wbyne/dl_2_eagle/afb_r005_BOM_7May21_2250.ods

Component | Supplier | Part_No | Value | Type | Size | Item | Part | Part_Source | Schematic_Part | Value | Device | Package | Description | AVAILABILITY | BOM | BUILT_BY | COPYRIGHT | DATASHEET | DESCRIPTION | DIGI-KEY_PART_NUMBER | MANUFACTURER_PART_NUMBER | MF | MP | MPN | OC_FARNELL | OC_NEWARK | PACKAGE | PRICE | PURCHASE-URL | SOURCELIBRARY | SUPPLIER | VENDOR
RTC | Digikey | 36-1070CT-ND - Cut Tape (CT) |  | SMD |  | CR1120 SMD Coin Cell holder | B1 | Schematic | B1 | cr1220 | BATTERYCR1220_2 | CR1220-2 | CR1220 SMT - Digikey: 3001K-ND
Power_Supply | Mouser | 81-GRM21R60J226ME39L | 22uF/6.3V | SMD |  |  | C2 | Datasheet | C4 | 22uF | C-USC0805 | C0805 | CAPACITOR, American symbol
Power_Supply | Mouser | 81-GRM21A5C2E201JW1D | 200pF | SMD |  |  | C3 | Datasheet | C5 | 200pF | C-USC0805 | C0805 | CAPACITOR, American symbol
Power_Supply | Mouser | 81-GRT21BC71E106KE13 | 10uF/24V | SMD |  |  | C1 | Datasheet | C6 | 10uF | C-USC0805 | C0805 | CAPACITOR, American symbol
Power_Supply | Mouser | 80-C0805X104M5RACTU | 100nF | SMD |  |  | C4 | Datasheet | C7 | 100nF | C-USC0805 | C0805 | CAPACITOR, American symbol
Power_Supply | Mouser | 81-GRM21R60J226ME39L | 22uF/6.3V | SMD |  |  | C2 | Datasheet | C8 |  | C-USC0805 | C0805 | CAPACITOR, American symbol
Relay | Mouser | 512-1N4148 | 1N4148 |  |  |  |  | Schematic | D1 | 1N4148 | DIODESOD-323 | SOD-323 | Diode
 | Mouser | SML-H12U8TT86C |  |  |  |  |  |  | D2 | RED | LED0805_NOOUTLINE | CHIPLED_0805_NOOUTLINE | LED
Power_Supply | Mouser | 621-B340A-F | B340A-13-F | SMD |  | DIODES INC. - B340A-13-F - Schottky Rectifier, 40 V, 3 A, Single, DO-214AC (SMA), 2 Pins, 500 mV | D1 | Datasheet | D4 | B340A-13-F | B340A-13-F | DIOM5226X240N | Diode, Rectifier, 3a, 40v, Do-214ac, Full Reel |  |  |  |  |  | Diode Schottky 40V 3A Surface Mount SMA | B340A-FDICT-ND |  | Diodes Inc. | B340A-13-F |  |  |  | DO-214 Diodes Inc. |  | https://pricing.snapeda.com/search/part/B340A-13-F/?ref=eda
 |  |  |  |  |  |  |  |  | FID1 | FIDUCIAL_1MM | FIDUCIAL_1MM | FIDUCIAL_1MM | Fiducial Alignment Points |  | EXCLUDE
RTC | Digikey | 700-DS3231SN# | DS3231 | SMD |  |  | DS3231 | Schematic | IC2 | DS3231/SO | DS3231/SO | SO16W |  | Unavailable |  |  |  |  | Real Time Clock (RTC) IC Clock/Calendar I²C, 2-Wire Serial 16-SOIC (0.295, 7.50mm Width) |  |  | Maxim Integrated | DS3231 |  |  |  | SOIC-16 Maxim Integrated | None
Feather_Mount | Mouser/Adafruit | 485-2830 |  |  |  | 12pin/16pin Stacking Headers for Feather | JP2/JP8 | Schematic | JP2 |  | HEADER-1X16ROUND | 1X16_ROUND | PIN HEADER
 | Mouser/Adafruit | 485-392 |  |  |  | 10 Pack of Male Headers |  |  | JP3 |  | PINHD-1X12-CB | 1X12-CB | PIN HEADER
 |  |  |  |  |  | 10 Pack of Male Headers |  |  | JP4 |  | HEADER-1X1ROUND | 1X01_ROUND | PIN HEADER
 |  |  |  |  |  | 10 Pack of Male Headers |  |  | JP5 |  | PINHD-1X12-CB | 1X12-CB | PIN HEADER
 |  |  |  |  |  | 10 Pack of Male Headers |  |  | JP6 |  | HEADER-1X1ROUND | 1X01_ROUND | PIN HEADER
 |  |  |  |  |  | 10 Pack of Male Headers |  |  | JP7 |  | PINHD-1X18 | 1X18 | PIN HEADER
Feather_Mount | Mouser/Adafruit | 485-2830 |  |  |  | 12pin/16pin Stacking Headers for Feather | JP2/JP8 | Schematic | JP8 |  | PINHD-1X12-CB | 1X12-CB | PIN HEADER
Power_Supply | Digikey | 732-4115-1-ND - Cut Tape (CT) | 15uH | SMD |  |  | L1 | Datasheet | L1 | 15uH | WE-PD-744771115_1260/1245/1280/1210 | WE-PD_1260/1245/1280/1210 | SMD-Shielded Power Inductors WE-PD |  |  |  |  |  |  |  |  |  |  | 744771115 | 1635908 | 08P2786 | 1260 |  |  |  | Wuerth Elektronik
 | Mouser | 863-NSVMMBT2222AM3T5 |  |  |  |  |  |  | Q1 | MMBT2222 | TRANSISTOR_NPN | SOT23-R | NPN Transistor
SCL_Pullup |  |  | 10k |  |  |  | R1 | Schematic | R1 | 10K | RESISTOR_0603_NOOUT | 0603-NO | Resistors
SDA_Pullup |  |  | 10k |  |  |  | R2 | Schematic | R2 | 10K | RESISTOR_0603_NOOUT | 0603-NO | Resistors
SD_CS_Pullup |  |  | 100k |  |  |  | R3 | Schematic | R3 | 100K | RESISTOR_0603_NOOUT | 0603-NO | Resistors
RTC | Mouser | 71-CRCW080510K0JNEAC | 10k | SMD |  |  | R4 | Schematic | R4 | 10k | R-US_R0805 | R0805 | RESISTOR, American symbol
 | Mouser | 71-CRCW08051K00JNEAC |  |  |  |  |  |  | R5 | 1K | RESISTOR0805_NOOUTLINE | 0805-NO | Resistors
 | Mouser | 71-CRCW080510K0JNEAC |  |  |  |  |  |  | R6 | 10K | RESISTOR0805_NOOUTLINE | 0805-NO | Resistors
 | Mouser | 71-CRCW080510K0JNEAC |  |  |  |  |  |  | R7 | 10K | RESISTOR0805_NOOUTLINE | 0805-NO | Resistors
Power_Supply | Mouser | 71-TNPW080540K2BEEA | 40.2k | SMD | 805 | resistor | R2 | Datasheet | R8 | 40.2k | R-US_R0805 | R0805 | RESISTOR, American symbol
Power_Supply | Mouser | 71-CRCW0805-365K-E3 | 365k | SMD |  |  | R4 | Datasheet | R9 | 365k | R-US_R0805 | R0805 | RESISTOR, American symbol
Power_Supply | Mouser | 71-CRCW0805-63.4K | 63.4k | SMD |  |  | R3 | Datasheet | R10 | 63.4k | R-US_R0805 | R0805 | RESISTOR, American symbol
Power_Supply | Mouser | 71-CRCW0805-162K | 162k | SMD | 805 | resistor | R1 | Datasheet | R15 | 162k | R-US_R0805 | R0805 | RESISTOR, American symbol
Feather_Mount | Mouser | 612-TL6330AF200Q |  |  |  | SWITCH_TACT_SMT4.6X2.8 (SWITCH_TACT_SMT) |  |  | SW1 | KMR2 | SWITCH_TACT_SMT4.6X2.8 | BTN_KMR2_4.6X2.8 | SMT Tact Switches
 |  |  |  |  |  |  |  |  | U1 | MP1584 | MP1584 | SOIC8E_MPS |  |  |  | EMA_Cory | Copyright (C) 2018 Accelerated Designs. All rights reserved | https://www.monolithicpower.com/en/documentview/productdocument/index/version/2/document_type/Datasheet/lang/en/sku/MP1584/document_id/204 |  |  | MP1584 |  |  |  |  |  |  |  |  | MPS_2020-01-27 |  | Monolithic Power Systems Inc
 | Digikey | 399-11000-1-ND - Cut Tape (CT) |  |  |  |  |  |  | X1 | RELAY_NONLATCHING-EE2NUH | RELAY_NONLATCHING-EE2NUH | RELAY_EE2_NOLATCH
 | Mouser | 651-1071011 |  |  |  |  |  |  | X3 |  | TERMBLOCK_1X3 | TERMBLOCK_1X3-3.5MM | 3.5mm Terminal block
 | Mouser | 538-47352-1001 |  |  |  |  |  |  | X4 | microsd | MICROSD | MICROSD | MicroSD/Transflash Card Holder with SPI pinout
Power_Supply |  |  | N/A | SMD |  |  | R5 | Datasheet
Power_Supply |  |  | N/A | SMD |  |  | R6 | Datasheet
