wbyne/dl_2_eagle/DL3R1005C_export_from_mouser_13may21_0915.xls

DL3R1005C_LMR23610
Mouser # | Mfr. # | Manufacturer | Customer # | Description | RoHS | Lifecycle | Order Qty. | Price (USD) | Ext.: (USD)
603-RT0805FRE0766K5L | RT0805FRE0766K5L | Yageo |  | Thin Film Resistors - SMD 1/8W 66.5K ohm 1% 50ppm | RoHS Compliant By Exemption |  | 10 | $0.055 | $0.55
71-TNPW080522K1FEEA | TNPW080522K1FEEA | Vishay |  | Thin Film Resistors - SMD 22.1Kohms 1% 25ppm | RoHS Compliant |  | 10 | $0.318 | $3.18
595-LMR23610ADDA | LMR23610ADDA | Texas Instruments |  | Switching Voltage Regulators 36V, 1A, Sync Step-Down | RoHS Compliant |  | 10 | $3.47 | $34.70
810-C3225X7R1H106MAC | C3225X7R1H106M250AC | TDK |  | Multilayer Ceramic Capacitors MLCC - SMD/SMT RECOMMENDED ALT 810-C3225X7R1H106250 | RoHS Compliant |  | 10 | $0.612 | $6.12
994-MSS6132T-223MLC | MSS6132T-223MLC | Coilcraft |  | Fixed Inductors 22uH Shld 20% 1.9A 158mOhms | RoHS Compliant |  | 10 | $1.26 | $12.60
963-UMF212B7104KGHT | UMF212B7104KGHT | Taiyo Yuden |  | Multilayer Ceramic Capacitors MLCC - SMD/SMT 0805 50VDC 0.1uF 10% X7R AEC-Q200 | RoHS Compliant | New Product | 10 | $0.101 | $1.01
74-T55A107M6R3C0100 | T55A107M6R3C0100 | Vishay |  | Tantalum Capacitors - Polymer 100uF 6.3volts 20% A Case 100 Max. ESR | RoHS Compliant |  | 10 | $0.55 | $5.50
187-CL21B225KPFNNNG | CL21B225KPFNNNG | Samsung Electro-Mechanics |  | Multilayer Ceramic Capacitors MLCC - SMD/SMT 2.2uF+/-10% 10V X7R 2012 | RoHS Compliant | New At Mouser | 10 | $0.086 | $0.86
652-CMP0805AFX-1003L | CMP0805AFX-1003ELF | Bourns |  | Thick Film Resistors - SMD 100K OHM 1% 1/2W TC100 | RoHS Compliant | New Product | 10 | $0.115 | $1.15
78-1N4148WS-E3-08 | 1N4148WS-E3-08 | Vishay |  | Diodes - General Purpose, Power, Switching 100 Volt 350mA | RoHS Compliant |  | 10 | $0.201 | $2.01
80-EE2-12NUX-L | EE2-12NUX-L | KEMET |  | Low Signal Relays - PCB KEMET, EE2, Relays, Signal | RoHS Compliant |  | 10 | $1.83 | $18.30
71-CRCW080510K0JNEAC | CRCW080510K0JNEAC | Vishay | R4 | Thick Film Resistors - SMD 1/8Watt 10Kohms 5% Commercial Use | RoHS Compliant By Exemption |  | 10 | $0.039 | $0.39
538-47352-1001 | 47352-1001 | Molex | X4 | Memory Card Connectors TFR PUSH PUSH TYPE V YPE VSS DEECT SWITCH | RoHS Compliant |  | 10 | $3.32 | $33.20
651-1071011 | 1071011 | Phoenix Contact | X3 | Fixed Terminal Blocks SPTAF 1/ 3-3 5-IL-EX |  | New Product | 10 | $1.87 | $18.70
612-TL6330AF200Q | TL6330AF200Q | E-Switch | SW1 | Tactile Switches SMT, miniature, IP67, 2.80mm x 4.60mm x 1.90mm tact switch, 1VA @ 32VDC, SPST, 200gf | RoHS Compliant |  | 10 | $0.68 | $6.80
71-CRCW08051K00JNEAC | CRCW08051K00JNEAC | Vishay | R5 | Thick Film Resistors - SMD 1/8Watt 1Kohms 5% Commercial Use | RoHS Compliant By Exemption |  | 10 | $0.039 | $0.39
863-NSVMMBT2222AM3T5 | NSVMMBT2222AM3T5G | ON Semiconductor | Q1 | Bipolar Transistors - BJT SS SOT-723 GP TRANSISTOR | RoHS Compliant |  | 10 | $0.314 | $3.14
485-2830 | 2830 | Adafruit | JP2 | Adafruit Accessories Stacking Headers for Feather - 12-pin and 16-pin female headers | RoHS Compliant |  | 10 | $1.25 | $12.50
485-392 | 392 | Adafruit | JP3-7 | Adafruit Accessories 36-pin Male Header Breakaway 10 pieces | RoHS Compliant |  | 4 | $4.95 | $19.80
700-DS3231S# | DS3231S# | Maxim Integrated | IC2 | Real Time Clock Extremely Accurate I C-Integrated RTC/TCXO/Crystal | RoHS Compliant By Exemption |  | 10 | $8.07 | $80.70
755-SML-H12U8TT86C | SML-H12U8TT86C | ROHM Semiconductor | D2 | Standard LEDs - SMD Red 620nm 40mcd 2.2V; 20mA 0805 | RoHS Compliant |  | 10 | $0.283 | $2.83
855-S8411-45R | S8411-45R | Harwin | B1 | Coin Cell Battery Holders EZ BDWR, SMT COIN CELL HOLDER CR1220 | RoHS Compliant |  | 10 | $1.02 | $10.20
