wbyne/dl_2_eagle/afb_r003_sch.pdf

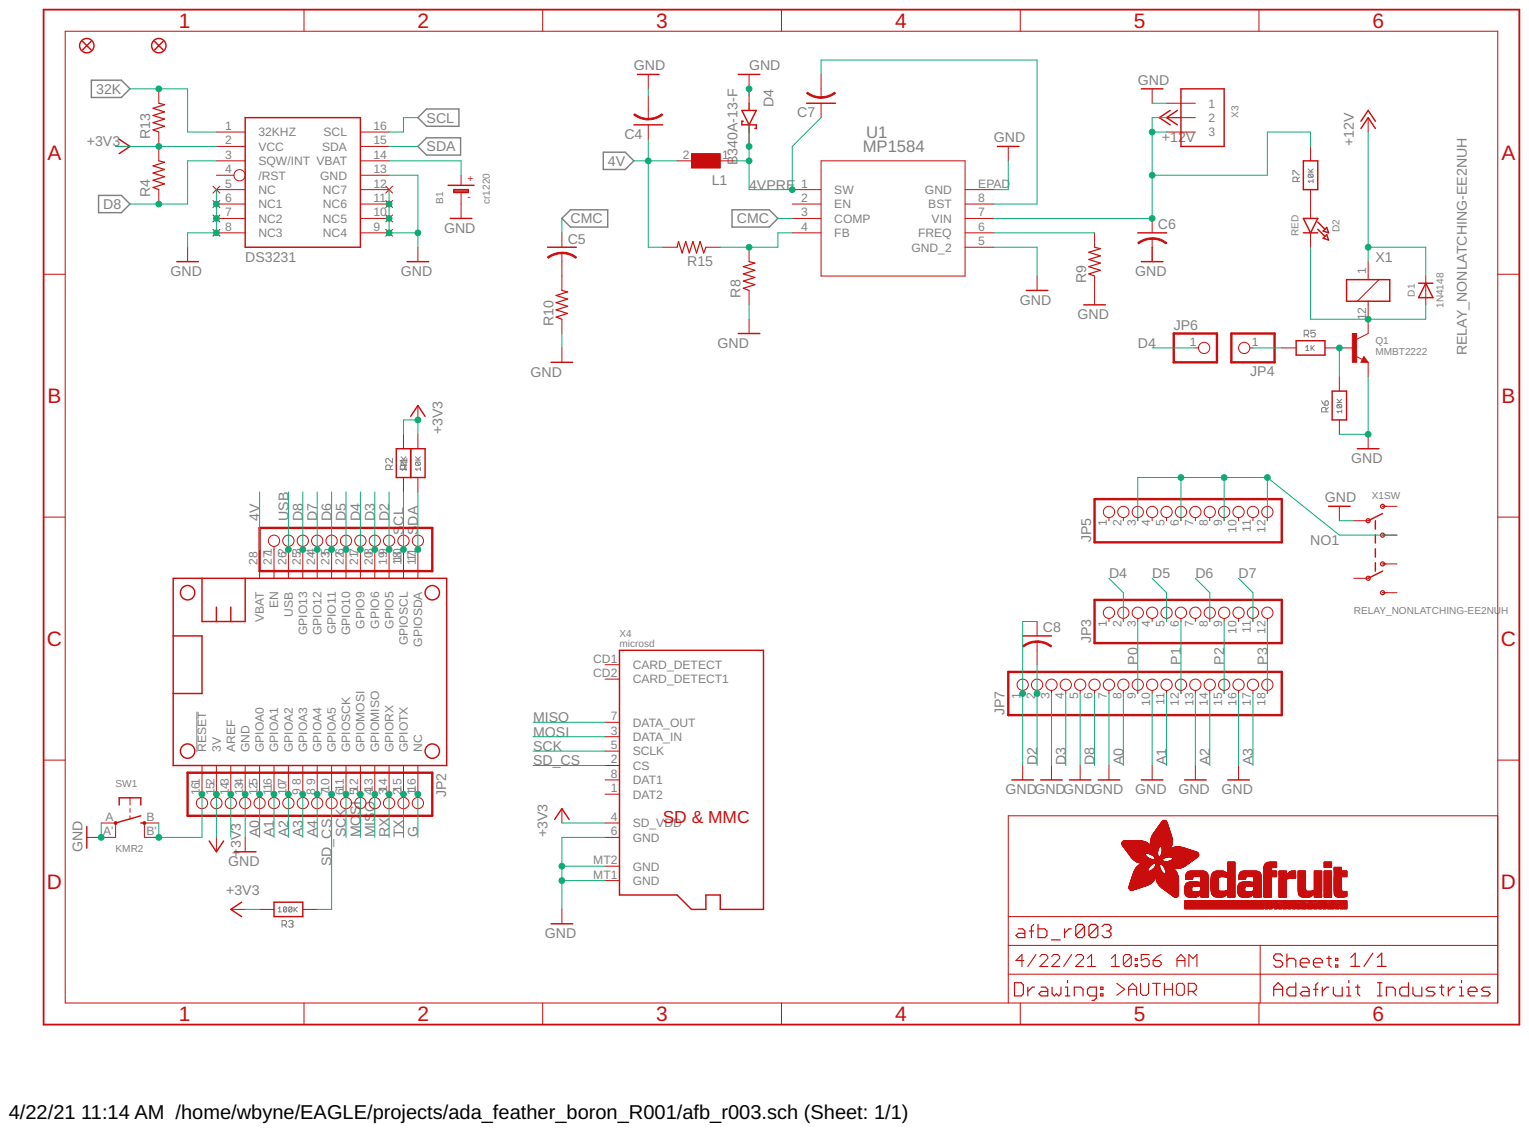
[picture p1: page 1]

GNDGNDGNDGND GND GND GND

4/22/21 11:14 AM /home/wbyne/EAGLE/projects/ada_feather_boron_R001/afb_r003.sch (Sheet: 1/1)
