wbyne/dl_2_eagle/afb_r003.pdf

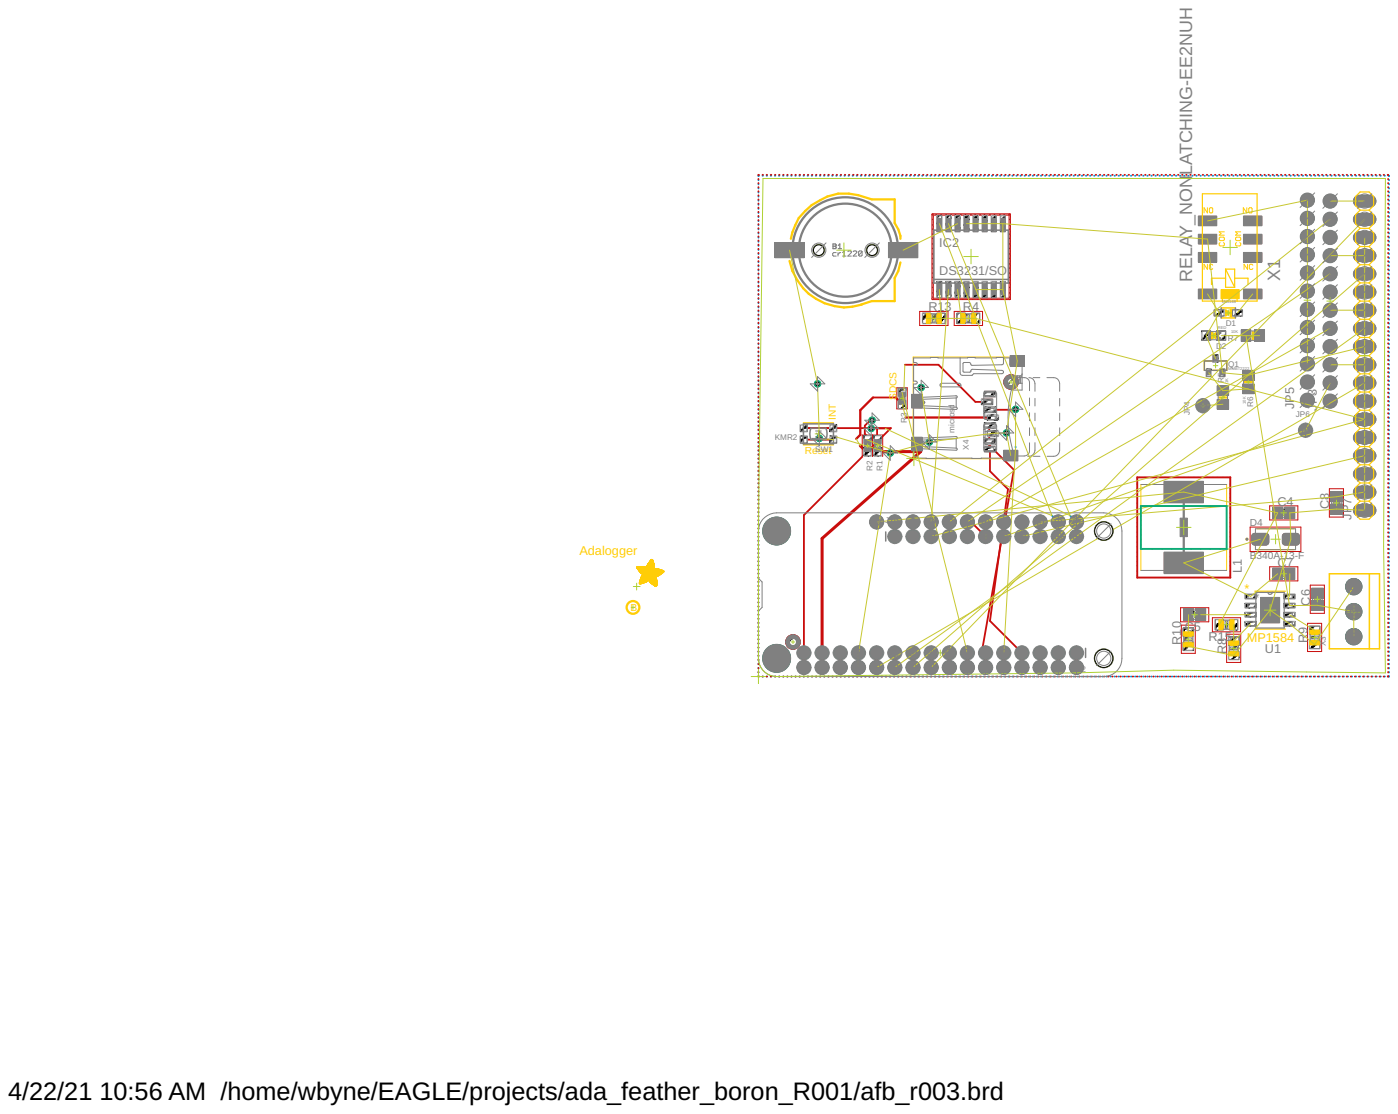
[picture p2: page 1]

4/22/21 10:56 AM /home/wbyne/EAGLE/projects/ada_feather_boron_R001/afb_r003.brd
