wbyne/dl_2_eagle/afb_r005_revc.brd

## EAGLE design afb_r005_revc.brd (2021-05-13)

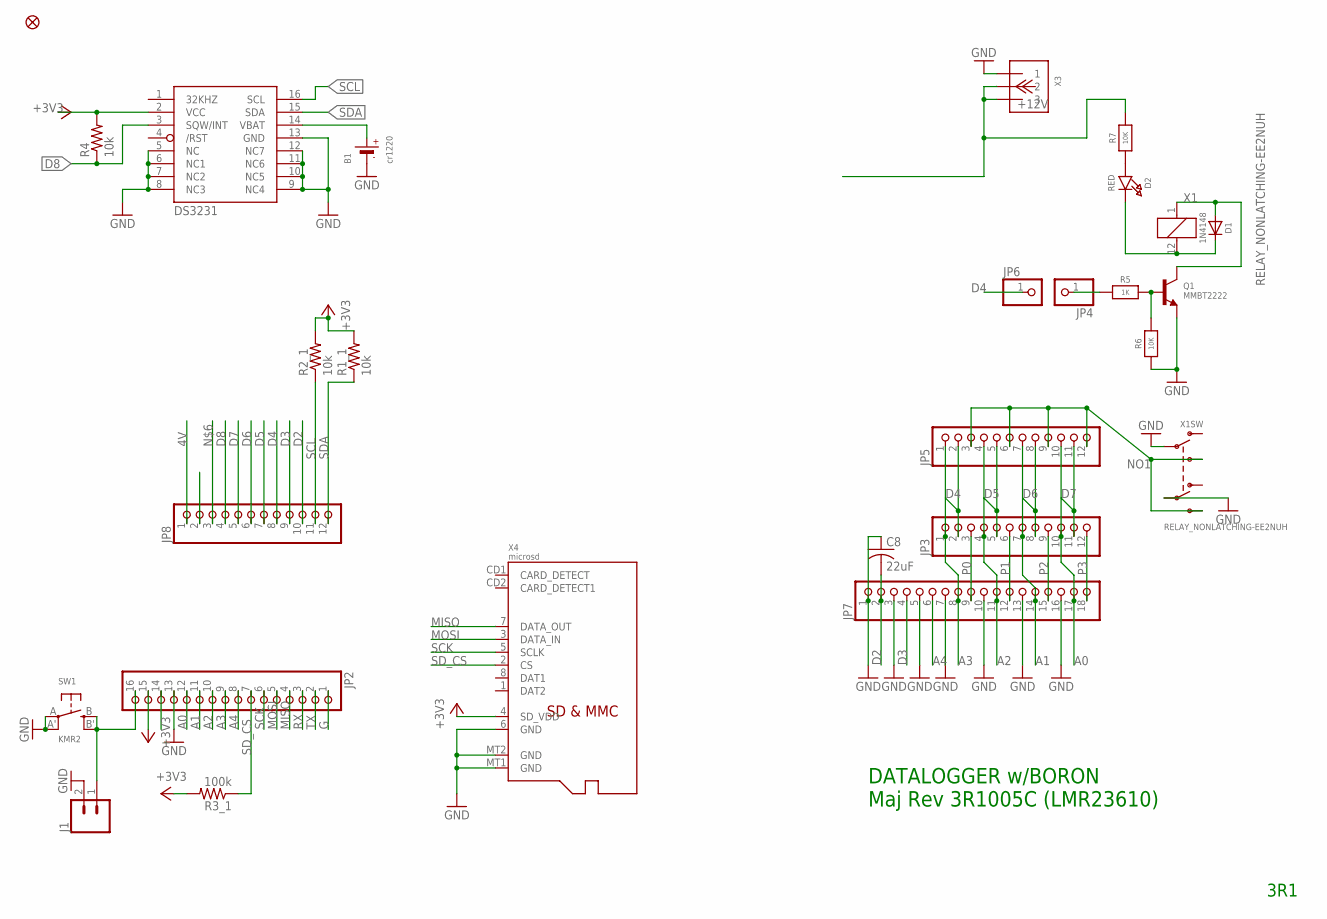
[picture p3: schematic afb_r005_revc.sch, sheet 1]

Parts:
B1: cr1220; CR1220-2
C8: 22uF; C0805
D1: 1N4148; SOD-323
D2: RED; CHIPLED_0805_NOOUTLINE
FID1: FIDUCIAL_1MM
IC2: DS3231/SO; SO16W
J1: CONN_02; 1X02
JP2: HEADER-1X16ROUND; 1X16_ROUND
JP3, JP5, JP8: PINHD-1X12-CB; 1X12-CB
JP4, JP6: HEADER-1X1ROUND; 1X01_ROUND
JP7: PINHD-1X18; 1X18
Q1: MMBT2222; SOT23-R
R1_1, R2_1, R4: 10k; R0805
R3_1: 100k; R0805
R5: 1K; 0805-NO
R6, R7: 10K; 0805-NO
SW1: KMR2; BTN_KMR2_4.6X2.8
X1: RELAY_NONLATCHING-EE2NUH; RELAY_EE2_NOLATCH
X3: TERMBLOCK_1X3; TERMBLOCK_1X3-3.5MM
X4: microsd; MICROSD

Connections:
4V: JP8.1; also elsewhere on the board
+3V3: IC2.2 (VCC), JP2.15, R1_1.2, R2_1.2, R3_1.2, R4.2, X4.4 (SD_VDD)
A0: JP2.12, JP3.10, JP5.10, JP7.17
A1: JP2.11, JP3.7, JP5.7, JP7.14
A2: JP2.10, JP3.4, JP5.4, JP7.11
A3: JP2.9, JP3.1, JP5.1, JP7.8
A4: JP2.8, JP7.6
AREF: JP2.14
D2: C8.2, JP7.2, JP8.10
D3: JP7.4, JP8.9
D4: JP3.2, JP5.2, JP6.1, JP8.8
D5: JP3.5, JP5.5, JP8.7
D6: JP3.8, JP5.8, JP8.6
D7: JP3.11, JP5.11, JP8.5
D8: IC2.3 (SQW/INT), JP8.4, R4.1
G: JP2.1
GND: B1.-, C8.1, IC2.5 (NC), IC2.6 (NC1), IC2.7 (NC2), IC2.8 (NC3), IC2.9 (NC4), IC2.10 (NC5), IC2.11 (NC6), IC2.12 (NC7), IC2.13 (GND), J1.2, JP2.13, JP7.1, JP7.3, JP7.5, JP7.7, JP7.10, JP7.13, JP7.16, Q1.2 (E), R6.1, SW1.A, SW1.A' (P1), X1.4 (P2), X1.9 (P1), X3.1, X4.6 (GND), X4.MT1 (GND), X4.MT2 (GND); also elsewhere on the board
MISO: JP2.4, X4.7 (DATA_OUT)
MOSI: JP2.5, X4.3 (DATA_IN)
unnamed: B1.+, IC2.14 (VBAT)
unnamed: D1.A, Q1.3 (C), X1.1
unnamed: D1.C, D2.C, X1.12 (2)
unnamed: Q1.1 (B), R5.2, R6.2
unnamed: JP4.1, R5.1
unnamed: D2.A, R7.1
NO1: JP5.3, JP5.6, JP5.9, JP5.12, X1.5 (S2), X1.8 (S1)
P0: JP3.3, JP7.9
P1: JP3.6, JP7.12
P2: JP3.9, JP7.15
P3: JP3.12, JP7.18
RESET: J1.1, JP2.16, SW1.B (S), SW1.B' (S1)
RX: JP2.3
SCK: JP2.6, X4.5 (SCLK)
SCL: IC2.16 (SCL), JP8.11, R2_1.1
SDA: IC2.15 (SDA), JP8.12, R1_1.1
SD_CS: JP2.7, R3_1.1, X4.2 (CS)
TX: JP2.2
VIN: R7.2, X3.2, X3.3; also elsewhere on the board

Notes on the sheet:
DATALOGGER w/BORON Maj Rev 3R1005C (LMR23610)
3R1

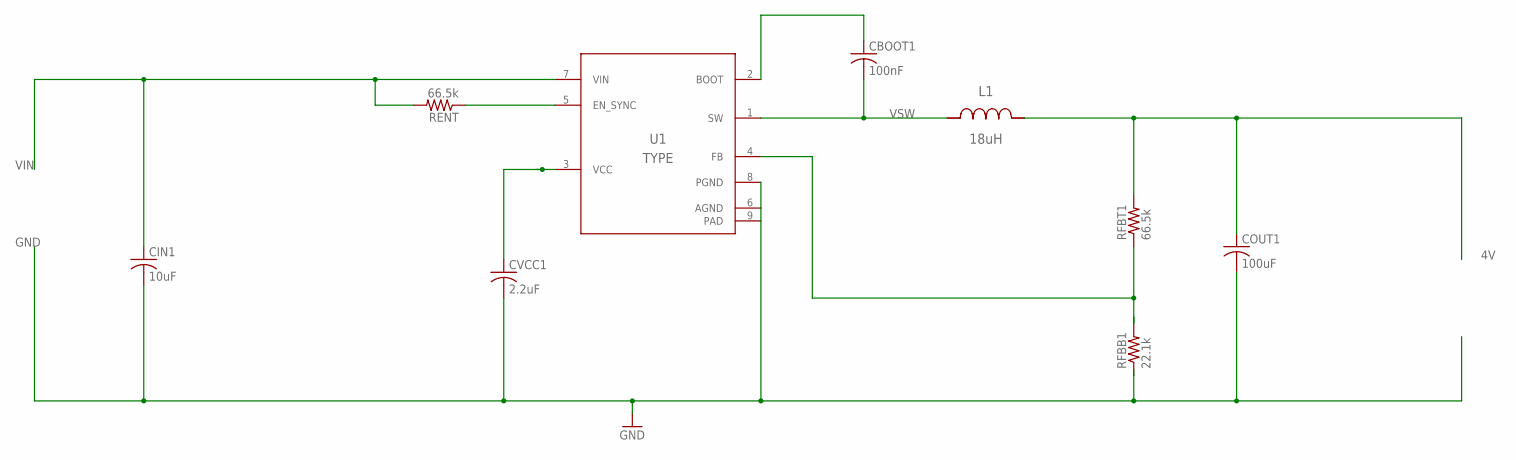
[picture p4: schematic afb_r005_revc.sch, sheet 2]

Parts:
CBOOT1: 100nF; C0805
CIN1: 10uF; C0805
COUT1: 100uF; C3216
CVCC1: 2.2uF; C0805
L1: 18uH; IND_NPI54C
RENT: 66.5k; R0805
RFBB1: 22.1k; R0805
RFBT1: 66.5k; R0805
U1: Value; DDA0008E_N

Connections:
3: CVCC1.1, U1.3 (VCC)
4: CBOOT1.1, U1.2 (BOOT)
4V: COUT1.1, L1.2, RFBT1.2; also elsewhere on the board
FB: RFBB1.2, RFBT1.1, U1.4 (FB)
GND: CIN1.2, COUT1.2, CVCC1.2, RFBB1.1, U1.6 (AGND), U1.8 (PGND), U1.9 (PAD); also elsewhere on the board
unnamed: RENT.1, U1.5 (EN_SYNC)
VIN: CIN1.1, RENT.2, U1.7 (VIN); also elsewhere on the board
VSW: CBOOT1.2, L1.1, U1.1 (SW)

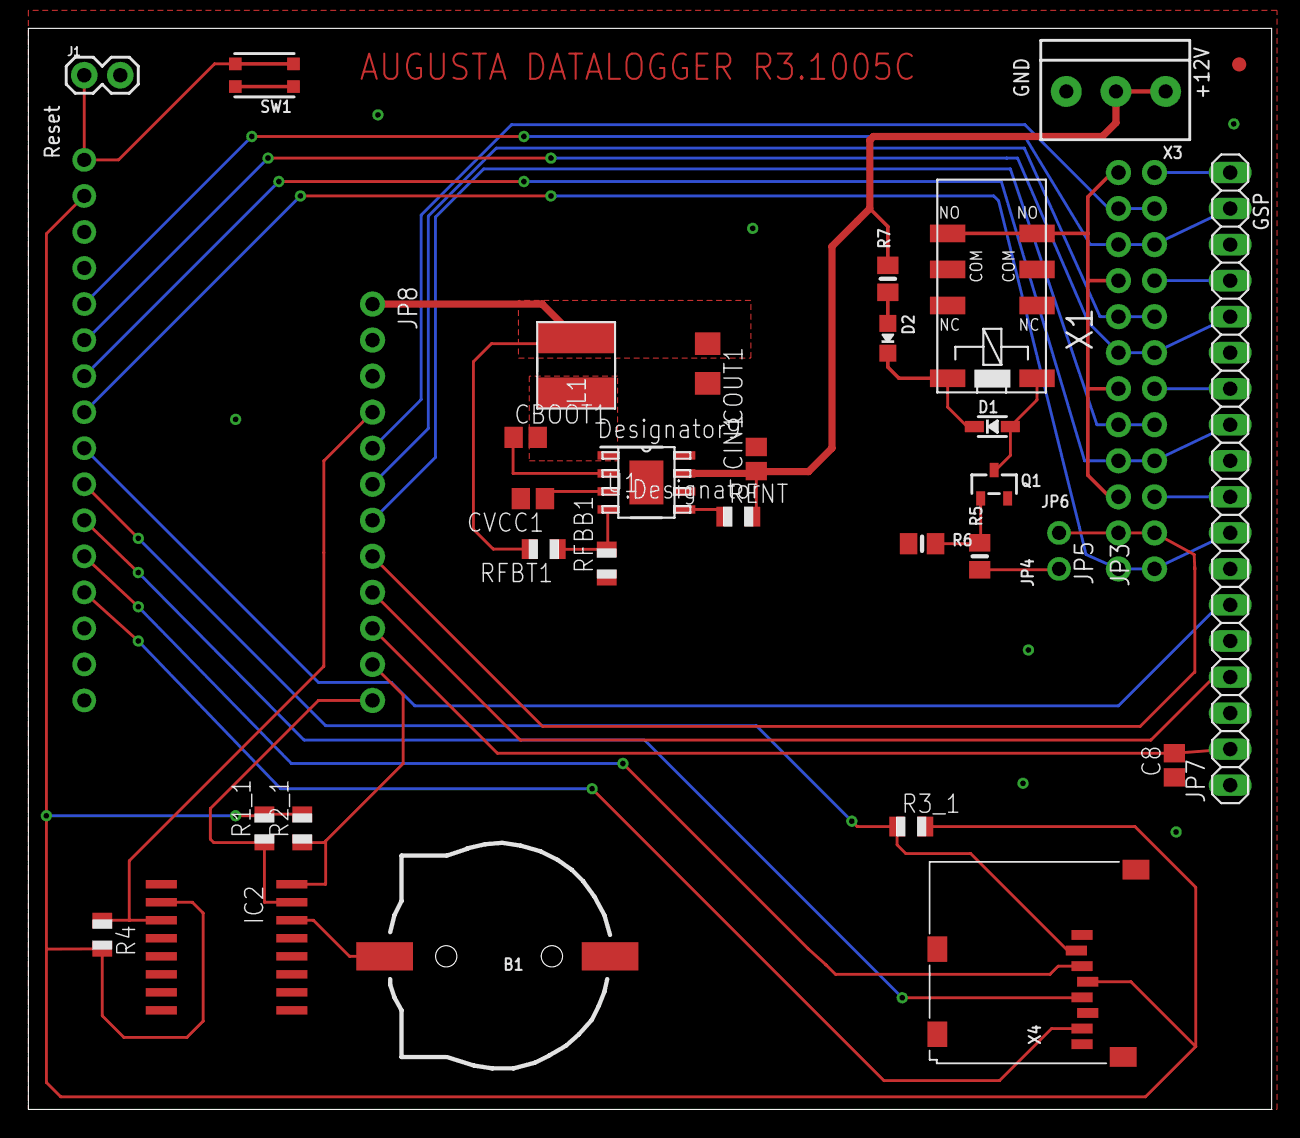
[picture p5: board afb_r005_revc.brd from above]

Board: 2 copper layers, 87.6 x 76.2 mm, 35 parts (0 on the bottom side), 39 nets.
