wbyne/dl_2_eagle/afb_r003.brd

## EAGLE design afb_r003.brd (2021-04-27)

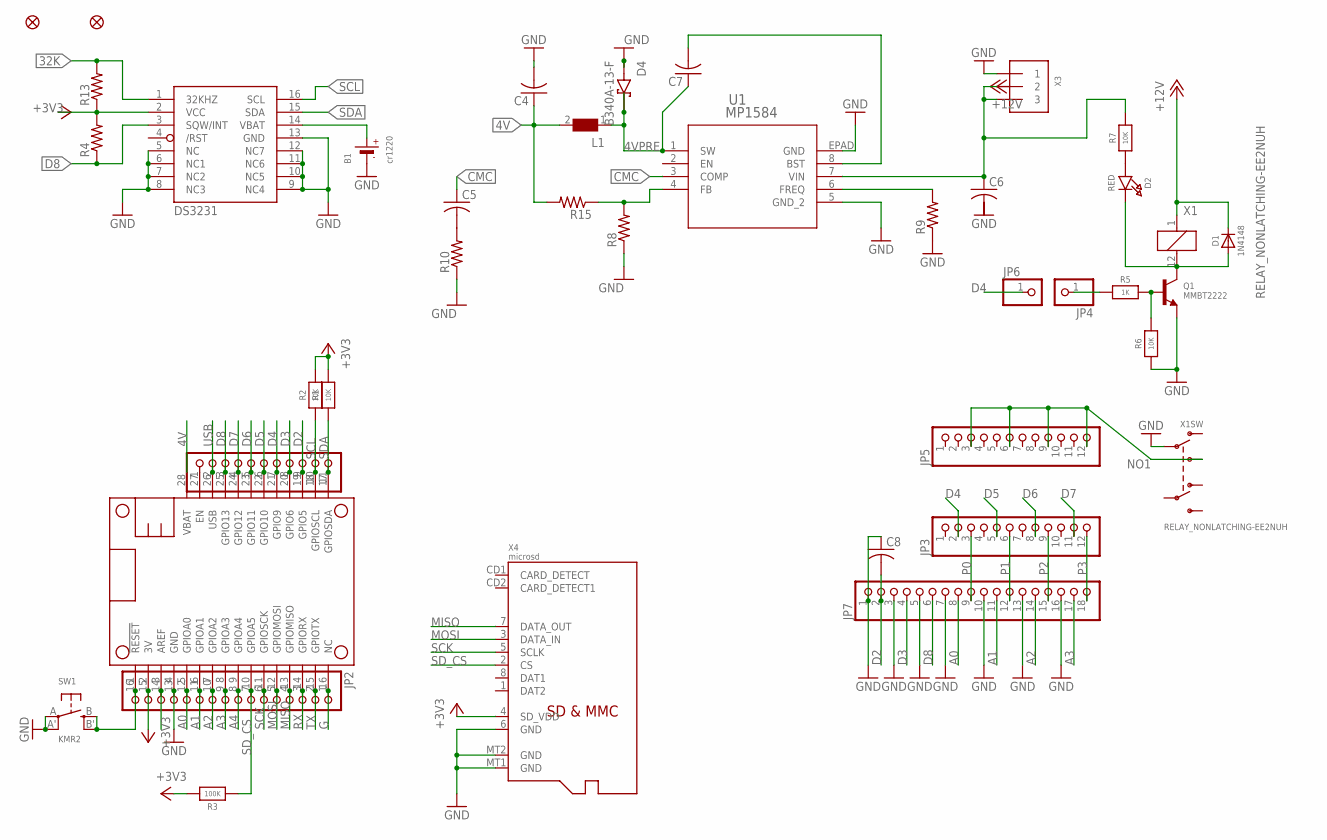
[picture p6: schematic afb_r003.sch]

Parts:
B1: cr1220; CR1220-2
C4, C5, C6, C7, C8: C-USC0805; C0805
D1: 1N4148; SOD-323
D2: RED; CHIPLED_0805_NOOUTLINE
D4: B340A-13-F; DIOM5226X240N
FID1, FID2: FIDUCIAL_1MM
IC2: DS3231/SO; SO16W
JP1: HEADER-1X11; 1X11_ROUND
JP2: HEADER-1X16ROUND; 1X16_ROUND
JP3, JP5: PINHD-1X12-CB; 1X12-CB
JP4, JP6: HEADER-1X1ROUND; 1X01_ROUND
JP7: PINHD-1X18; 1X18
L1: WE-PD-744771115_1260/1245/1280/1210; WE-PD_1260/1245/1280/1210
MS1: FEATHERWING_NODIM
Q1: MMBT2222; SOT23-R
R1, R2: 10K; 0603-NO
R3: 100K; 0603-NO
R4, R8, R9, R10, R13, R15: R-US_R0805; R0805
R5: 1K; 0805-NO
R6, R7: 10K; 0805-NO
SW1: KMR2; BTN_KMR2_4.6X2.8
U1: MP1584; SOIC8E_MPS
X1: RELAY_NONLATCHING-EE2NUH; RELAY_EE2_NOLATCH
X3: TERMBLOCK_1X3; TERMBLOCK_1X3-3.5MM
X4: microsd; MICROSD

Connections:
4V: C4.1, L1.2, MS1.28 (VBAT), R15.2
4VPRE: C7.1, D4.C, L1.1, U1.1 (SW)
32K: IC2.1 (32KHZ), R13.2
+3V3: JP2.15, MS1.2 (3V), R1.2, R2.2, R3.2, X4.4 (SD_VDD)
+12V: D1.C, X1.1
A0: JP2.12, JP7.8, MS1.5 (GPIOA0)
A1: JP2.11, JP7.11, MS1.6 (GPIOA1)
A2: JP2.10, JP7.14, MS1.7 (GPIOA2)
A3: JP2.9, JP7.17, MS1.8 (GPIOA3)
A4: JP2.8, MS1.9 (GPIOA4)
AREF: JP2.14, MS1.3 (AREF)
BSC: C7.2, U1.8 (BST)
CMC: C5.1, U1.3 (COMP)
D2: C8.2, JP1.9, JP7.2, MS1.19 (GPIO5)
D3: JP1.8, JP7.4, MS1.20 (GPIO6)
D4: JP1.7, JP3.2, JP6.1, MS1.21 (GPIO9)
D5: JP1.6, JP3.5, MS1.22 (GPIO10)
D6: JP1.5, JP3.8, MS1.23 (GPIO11)
D7: JP1.4, JP3.11, MS1.24 (GPIO12)
D8: IC2.2 (VCC), JP1.3, JP7.6, MS1.25 (GPIO13), R4.2, R13.1
EN: JP1.1, MS1.27 (EN)
G: JP2.1, MS1.16 (NC)
GND: B1.-, C4.2, C8.1, D4.A, IC2.5 (NC), IC2.6 (NC1), IC2.7 (NC2), IC2.8 (NC3), IC2.9 (NC4), IC2.10 (NC5), IC2.11 (NC6), IC2.12 (NC7), IC2.13 (GND), JP2.13, JP7.1, JP7.3, JP7.5, JP7.7, JP7.10, JP7.13, JP7.16, MS1.4 (GND), Q1.2 (E), R6.1, R8.1, R9.1, R10.1, SW1.A, SW1.A' (P1), U1.5 (GND_2), U1.EPAD (GND), X1.9 (P1), X3.1, X4.6 (GND), X4.MT1 (GND), X4.MT2 (GND)
MISO: JP2.4, MS1.13 (GPIOMISO), X4.7 (DATA_OUT)
MOSI: JP2.5, MS1.12 (GPIOMOSI), X4.3 (DATA_IN)
unnamed: B1.+, IC2.14 (VBAT)
unnamed: D1.A, D2.C, Q1.3 (C), X1.12 (2)
unnamed: R8.2, R15.1, U1.4 (FB)
unnamed: C5.2, R10.2
unnamed: C6.1, R7.2, U1.7 (VIN), X3.2, X3.3
unnamed: IC2.3 (SQW/INT), R4.1
unnamed: R9.2, U1.6 (FREQ)
unnamed: Q1.1 (B), R5.2, R6.2
unnamed: JP4.1, R5.1
unnamed: D2.A, R7.1
NO1: JP5.3, JP5.6, JP5.9, JP5.12, X1.8 (S1)
P0: JP3.3, JP7.9
P1: JP3.6, JP7.12
P2: JP3.9, JP7.15
P3: JP3.12, JP7.18
RESET: JP2.16, MS1.1 (!RESET), SW1.B (S), SW1.B' (S1)
RX: JP2.3, MS1.14 (GPIORX)
SCK: JP2.6, MS1.11 (GPIOSCK), X4.5 (SCLK)
SCL: IC2.16 (SCL), JP1.10, MS1.18 (GPIOSCL), R2.1
SDA: IC2.15 (SDA), JP1.11, MS1.17 (GPIOSDA), R1.1
SD_CS: JP2.7, MS1.10 (GPIOA5), R3.1, X4.2 (CS)
TX: JP2.2, MS1.15 (GPIOTX)
USB: JP1.2, MS1.26 (USB)

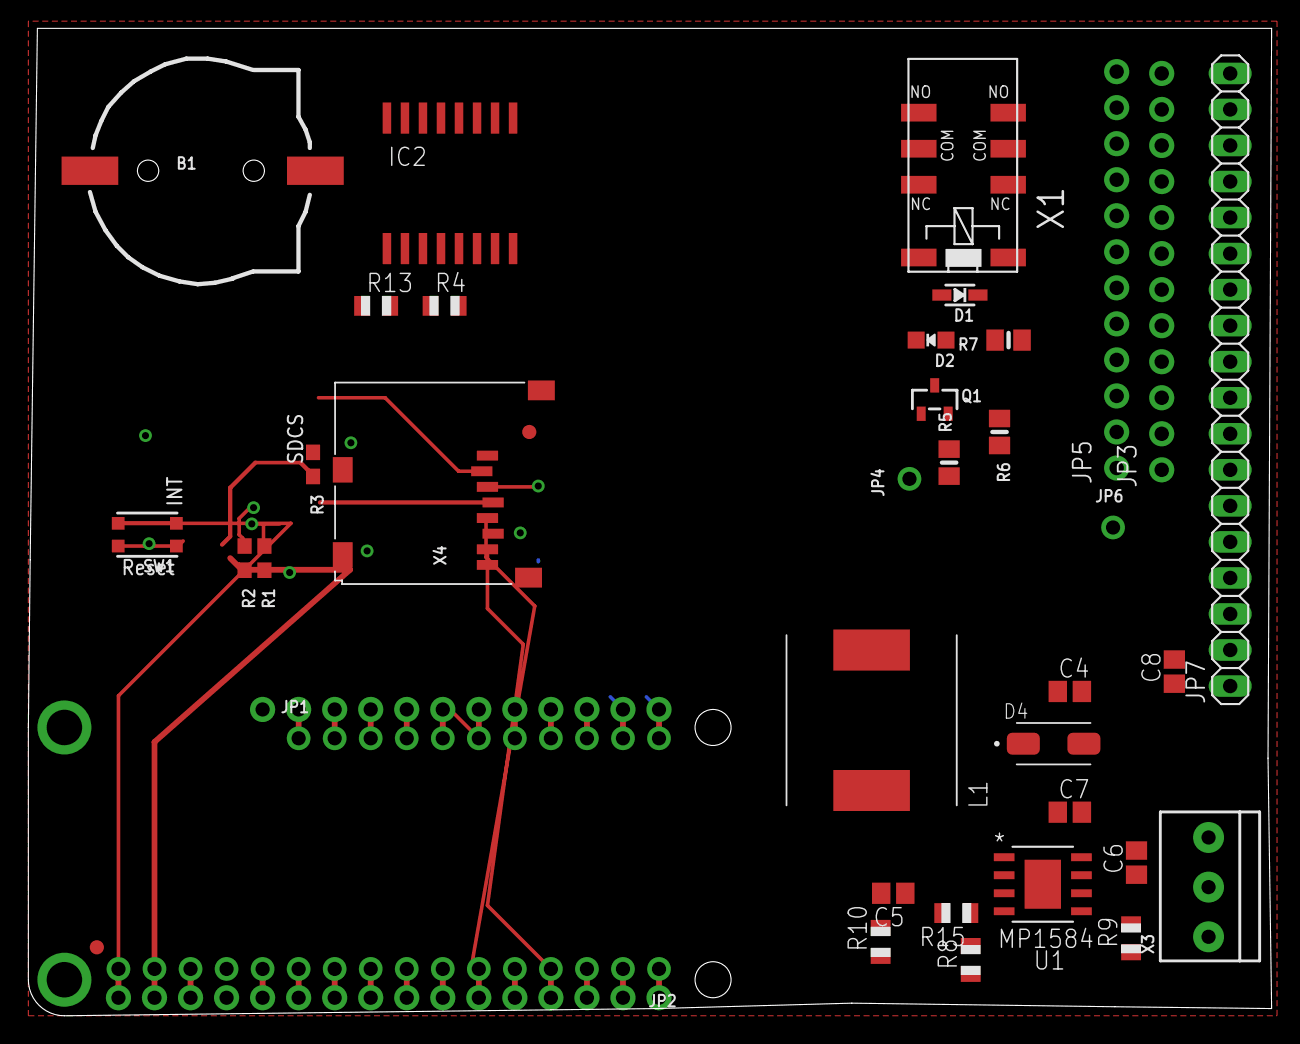
[picture p7: board afb_r003.brd from above]

Board: 2 copper layers, 87.6 x 69.6 mm, 41 parts (0 on the bottom side), 48 nets.

Other parts of the board:
U$4: ADAFRUIT_3.5MM
U$5: PCBFEAT-REV-040
