wbyne/dl_2_eagle/afb_r001.brd

## EAGLE design afb_r001.brd (2021-04-27)

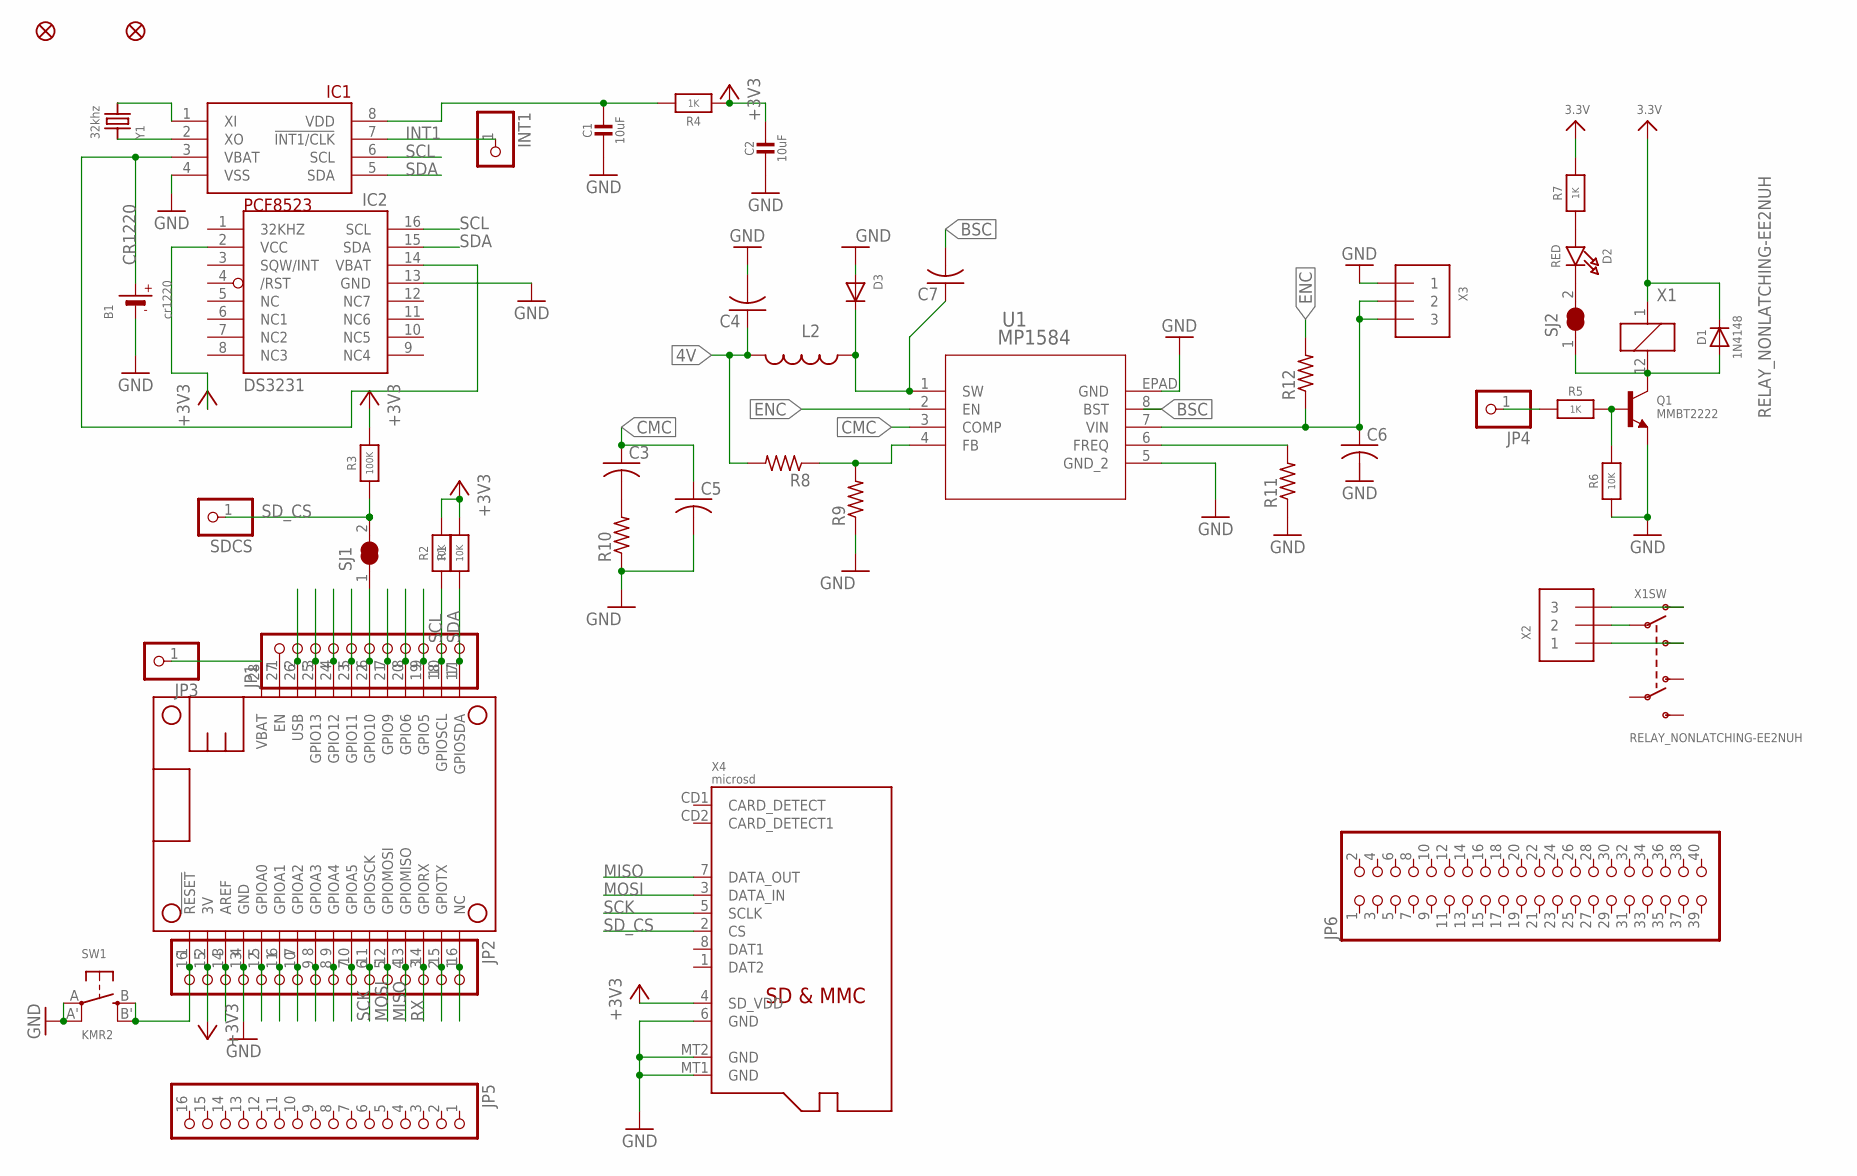
[picture p8: schematic afb_r001.sch]

Parts:
B1: cr1220; CR1220-2
C1, C2: 10uF; 0805-NO
C3, C4, C5, C6, C7: C-USC0603; C0603
D1: 1N4148; SOD-323
D2: RED; CHIPLED_0805_NOOUTLINE
D3: DIODESMA; SMADIODE
FID1, FID2: FIDUCIAL_1MM
IC1: PCF8523T; SOIC8_150MIL
IC2: DS3231/SO; SO16W
INT1: HEADER-1X1ROUND; 1X01_ROUND
JP1: HEADER-1X11; 1X11_ROUND
JP2, JP5: HEADER-1X16ROUND; 1X16_ROUND
JP3, JP4: HEADER-1X1ROUND; 1X01_ROUND
JP6: PINHD-2X20; 2X20
L2: L-USL3225M; L3225M
MS1: FEATHERWING_NODIM
Q1: MMBT2222; SOT23-R
R1, R2: 10K; 0603-NO
R3: 100K; 0603-NO
R4: 1K; 0603-NO
R5, R7: 1K; 0805-NO
R6: 10K; 0805-NO
R8: FLIPFLOP-RES; 0805-THM
R9, R10, R11, R12: R-US_R0603; R0603
SDCS: HEADER-1X1ROUND; 1X01_ROUND
SJ1, SJ2: SOLDERJUMPER_CLOSED; SOLDERJUMPER_CLOSEDWIRE
SW1: KMR2; BTN_KMR2_4.6X2.8
U1: MP1584; SOIC8E_MPS
X1: RELAY_NONLATCHING-EE2NUH; RELAY_EE2_NOLATCH
X2, X3: TERMBLOCK_1X3; TERMBLOCK_1X3-3.5MM
X4: microsd; MICROSD
Y1: 32khz; CRYSTAL_8X3.8

Connections:
3.3V: D1.C, R7.2, X1.1
4V: C4.1, C7.1, D3.C, L2.1, L2.2, R8.2, U1.1 (SW)
+3V3: C2.1, IC2.2 (VCC), JP2.15, MS1.2 (3V), R1.2, R2.2, R3.2, R4.1, X4.4 (SD_VDD)
A: JP2.12, MS1.5 (GPIOA0)
AREF: JP2.14, MS1.3 (AREF)
B: JP2.11, MS1.6 (GPIOA1)
BSC: C7.2
C: JP2.10, MS1.7 (GPIOA2)
CMC: C3.1, C5.1, U1.3 (COMP)
COM1: X1.9 (P1), X2.2
CR1220: B1.+, IC1.3 (VBAT), IC2.14 (VBAT)
CS: JP1.6, MS1.22 (GPIO10), SJ1.1
D: JP2.9, MS1.8 (GPIOA3)
E: JP2.8, MS1.9 (GPIOA4)
EN: JP1.1, MS1.27 (EN)
ENC: R12.2, U1.2 (EN)
F: JP2.7, MS1.10 (GPIOA5)
G: JP2.1, MS1.16 (NC)
GND: B1.-, C1.2, C2.2, C4.2, C5.2, D3.A, IC1.4 (VSS), IC2.13 (GND), JP2.13, MS1.4 (GND), Q1.2 (E), R6.1, R9.1, R10.1, R11.1, SW1.A, SW1.A' (P1), U1.5 (GND_2), U1.EPAD (GND), X3.1, X4.6 (GND), X4.MT1 (GND), X4.MT2 (GND)
H: JP1.9, MS1.19 (GPIO5)
I: JP1.8, MS1.20 (GPIO6)
INT1: IC1.7 (!INT1/CLK), INT1.1
J: JP1.7, MS1.21 (GPIO9)
L: JP1.5, MS1.23 (GPIO11)
M: JP1.4, MS1.24 (GPIO12)
MISO: JP2.4, MS1.13 (GPIOMISO), X4.7 (DATA_OUT)
MOSI: JP2.5, MS1.12 (GPIOMOSI), X4.3 (DATA_IN)
N: JP1.3, MS1.25 (GPIO13)
unnamed: C1.1, IC1.8 (VDD), R4.2
unnamed: D1.A, Q1.3 (C), SJ2.1, X1.12 (2)
unnamed: R8.1, R9.2, U1.4 (FB)
unnamed: C3.2, R10.2
unnamed: C6.1, R12.1, U1.7 (VIN), X3.2, X3.3
unnamed: IC1.1 (XI), Y1.P$4 (2)
unnamed: IC1.2 (XO), Y1.P$1 (1)
unnamed: R11.2, U1.6 (FREQ)
unnamed: Q1.1 (B), R5.2, R6.2
unnamed: JP4.1, R5.1
unnamed: D2.C, SJ2.2
unnamed: D2.A, R7.1
unnamed: X1.10 (O1), X2.3
NO1: X1.8 (S1), X2.1
RESET: JP2.16, MS1.1 (!RESET), SW1.B (S), SW1.B' (S1)
RX: JP2.3, MS1.14 (GPIORX)
SCK: JP2.6, MS1.11 (GPIOSCK), X4.5 (SCLK)
SCL: IC1.6 (SCL), JP1.10, MS1.18 (GPIOSCL), R2.1
SDA: IC1.5 (SDA), JP1.11, MS1.17 (GPIOSDA), R1.1
SD_CS: R3.1, SDCS.1, SJ1.2, X4.2 (CS)
TX: JP2.2, MS1.15 (GPIOTX)
USB: JP1.2, MS1.26 (USB)
VBAT: JP3.1, MS1.28 (VBAT)

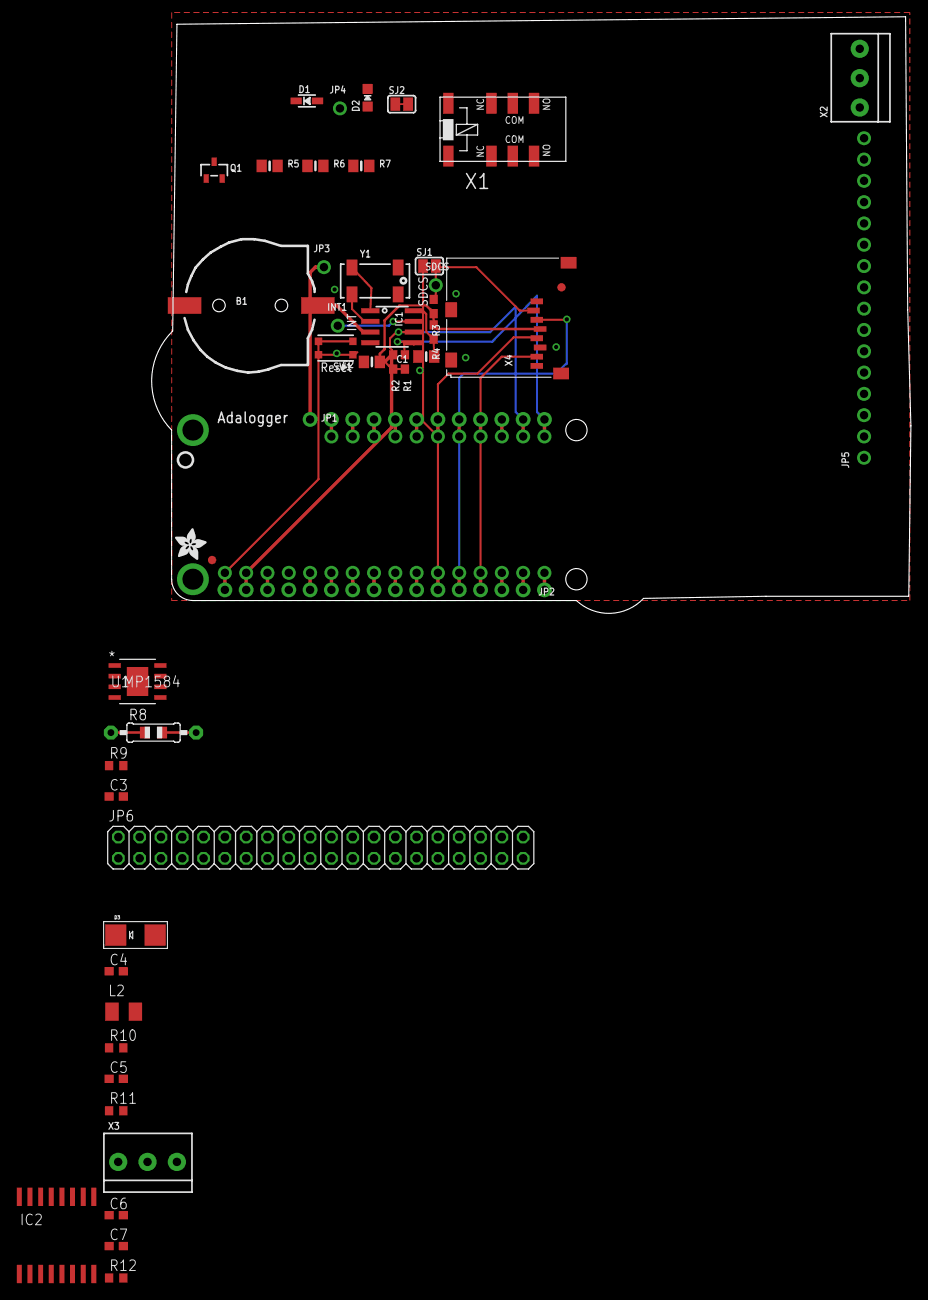
[picture p9: board afb_r001.brd from above]

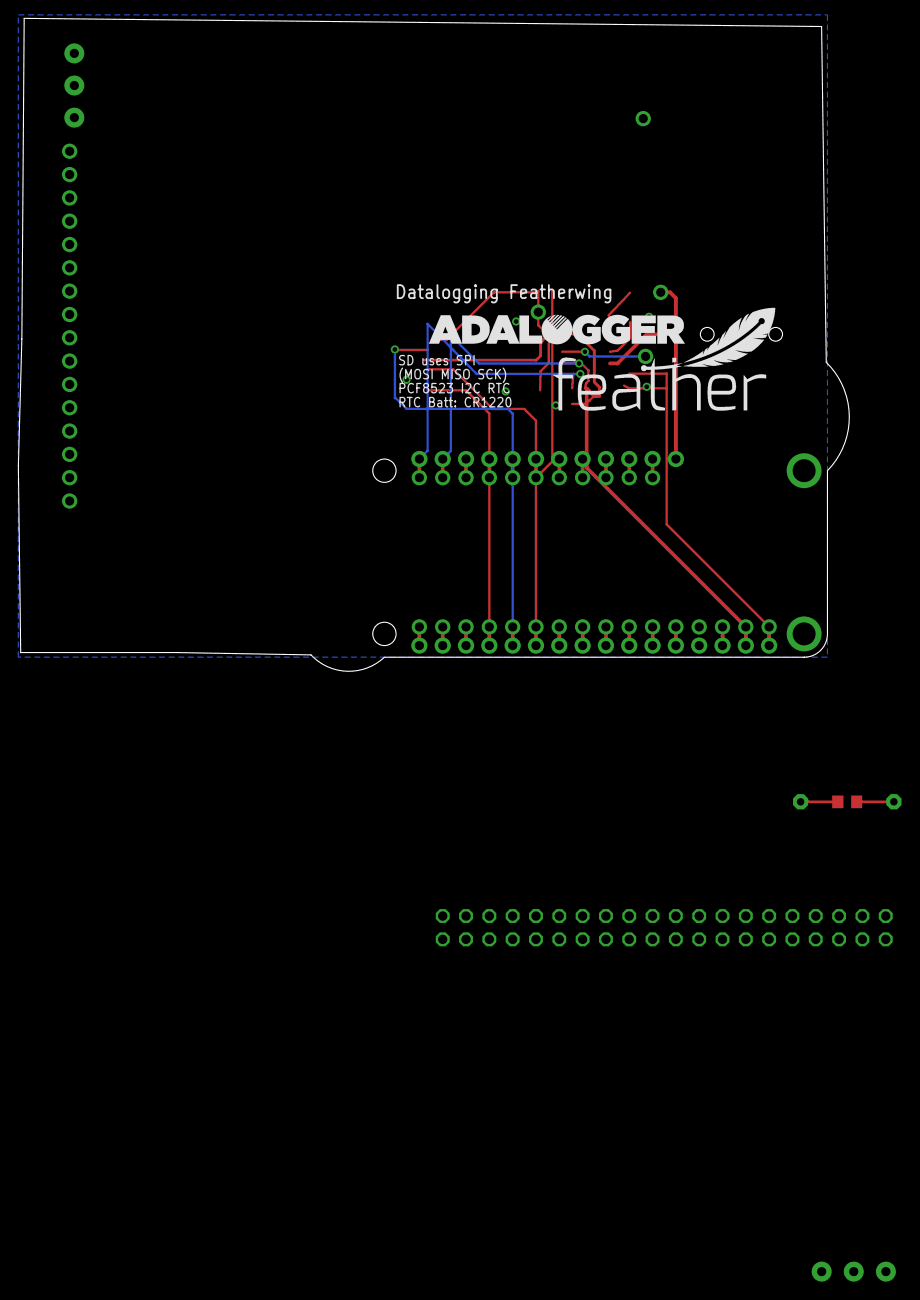
[picture p10: board afb_r001.brd from below]

Board: 2 copper layers, 90.5 x 71.1 mm, 51 parts (2 on the bottom side), 50 nets.

Other parts of the board:
U$2: FEATHERLOGO
U$3: ADALOGGER_LOGO
U$4: ADAFRUIT_3.5MM
U$5: PCBFEAT-REV-040
