wbyne/dl_2_eagle/(commit log)

2021-05-06 added R4 modifications and changed name to major rev 3. Need to clean up my naming.
    [afb_r004.brd, afb_r004.sch]
2021-05-13 Addition of Rev3.1005C, using TI2361 regulator
    [DL3R1005C_export_from_mouser_13may21_0915.xls, afb_r005.brd, afb_r005.sch, afb_r005_BOM_7May21_2250.csv, afb_r005_BOM_7May21_2250.ods, afb_r005_BOM_7May21_2250_TI23610.csv, afb_r005_BOM_7May21_2250_TI23610.ods, afb_r005_rev5.brd]
