wbyne/dl_2_eagle/(notices)

Notices in the files:
parts and their libraries:
COPYRIGHT: Copyright (C) 2018 Accelerated Designs. All rights reserved
SparkFun-Connectors: Licensing: Creative Commons ShareAlike 4.0 International - https://creativecommons.org/licenses/by-sa/4.0
